ruairiD11/ProjectY4/circuitDiagrams/controllingDCMotorPushButton.jpg

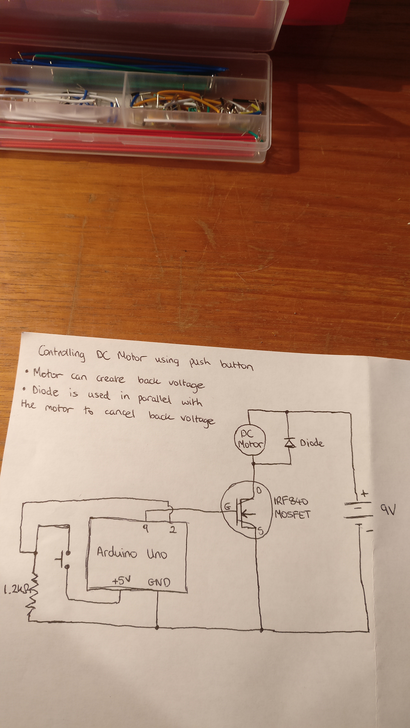
circuitDiagrams/controllingDCMotorPushButton.jpg
