ruairiD11/ProjectY4/circuitDiagrams/controlingDirectionDCMotorL293D.jpg

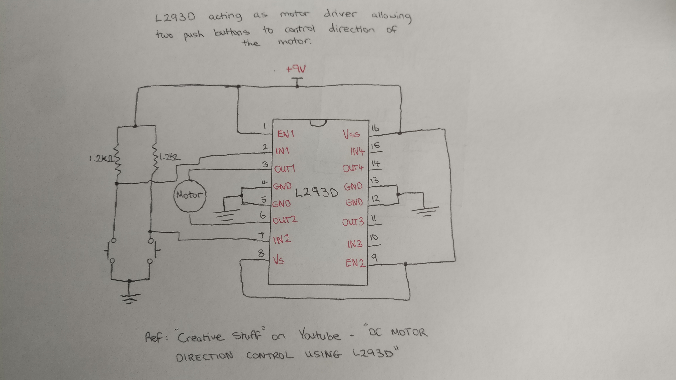
circuitDiagrams/controlingDirectionDCMotorL293D.jpg
