ruairiD11/ProjectY4/Remote-Robot-Report.pdf

Remote-Robot | Ruairí Doherty

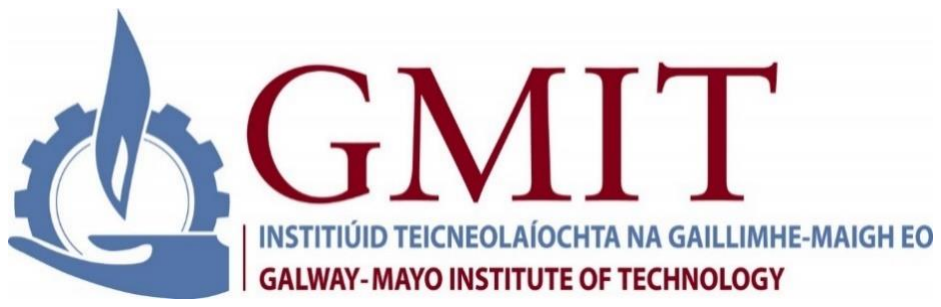
[picture p4: figure]

# Remote-Robot

# Final Year Project

# Ruairí Doherty

# Bachelor of Engineering (Hons) in Software & Electronic Engineering

# Galway-Mayo Institute of Technology

2019/2020

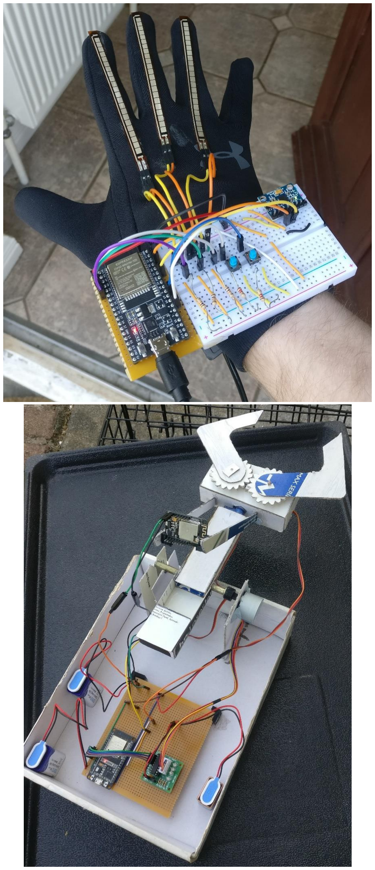
[picture p5: figure]

# Declaration

This project is presented in partial fulfilment of the requirements for the degree of Bachelor of Engineering (Hons) in Software & Electronic Engineering at Galway-Mayo Institute of Technology.

This project is my own work, except where otherwise accredited. Where the work of others has been used or incorporated during this project, this is acknowledged and referenced.

Ruairí Doherty

# Acknowledgements

Paul Lennon, Lecturer, Software & Electronic Engineering, Galway-Mayo Institute of Technology.

Niall O’ Keeffe, Lecturer, Software & Electronic Engineering, Galway-Mayo Institute of Technology.

Brian O’ Shea, Lecturer, Software & Electronic Engineering, Galway-Mayo Institute of Technology.

# Table of Contents

# 1. Project Overview

The Remote-Robot is a wireless, hand-gesture controlled robot. It’s purpose is for situations where precision is required, in environments that would be unsuitable for a human to operate in. For example – bomb disposal, radioactive environments or natural disaster relief. The project consists of two modules – the glove and robot arm. The glove uses flex sensors and an accelerometer to continuously monitor the user’s hand movements. It also has two push buttons to control the pitch of the robot arm. The robot module consists of two servo motors and one stepper motor. The servo motors are controlled by the flex sensors and accelerometer on the glove. The stepper motor handles the pitch of the robot, controlled by the push-buttons on the glove. Both of these modules communicate wirelessly, allowing remote control of the robot arm. A camera module mounted on the robot’s hand displays a livestream on a Node.js web-server, allowing the user to see what the robot can see. Real-time sensor data is also displayed on the server.

GitHub repository: https://github.com/ruairiD11/ProjectY4

# 2. Project Architecture

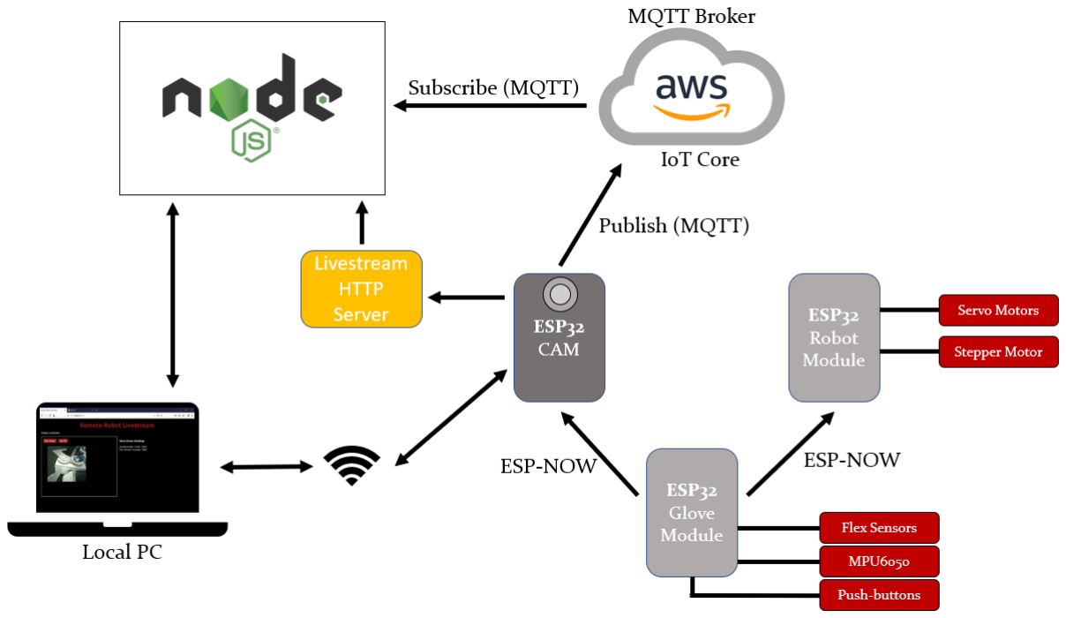
[picture p6: figure]

# 3. Schematics

## Glove Module

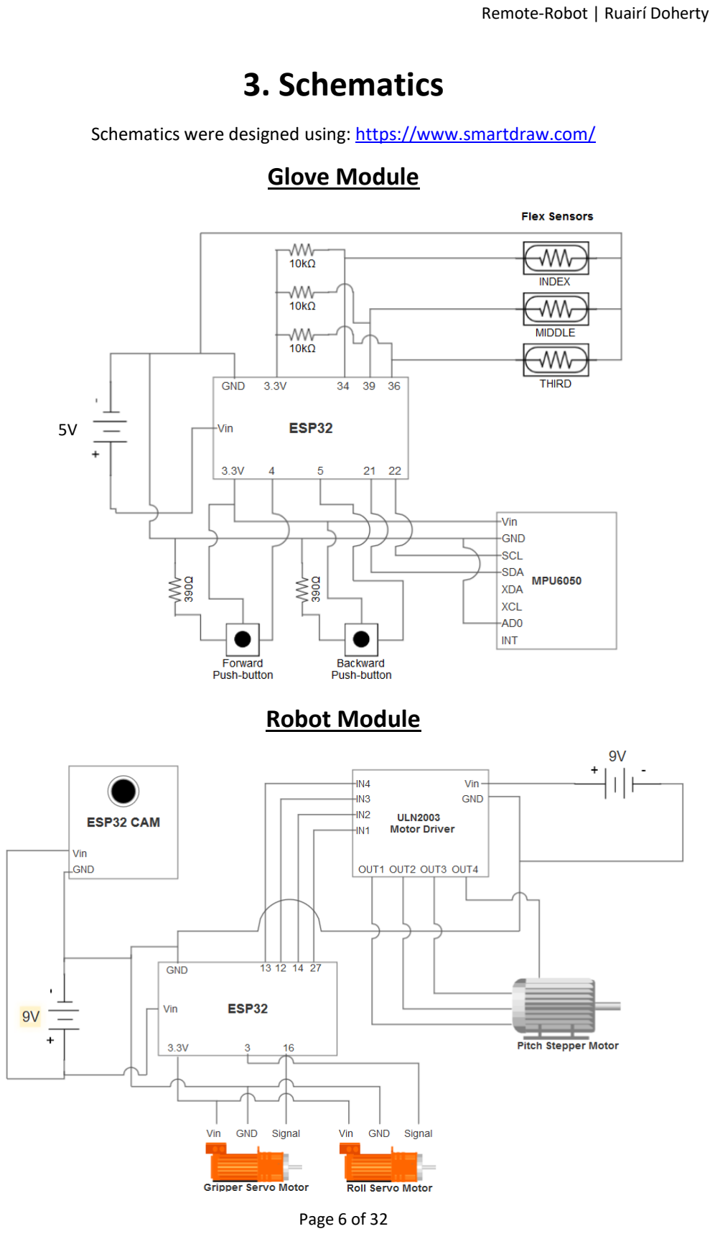
[picture p7: page 6]

Schematics were designed using: https://www.smartdraw.com/

## Robot Module

5V

# 4. Project Requirements

## 4.1 Functional

- The glove and the robot arm must communicate wirelessly.
- The glove module should be equipped with many sensors, to monitor the user’s hand movements.
- The Remote-Robot should accurately imitate the user’s hand movements.

## 4.2 Non-Functional

- The Remote-Robot should be able to be controlled from a significant distance (150 metres or more).
- The Remote-Robot should receive the glove sensor data every 50ms or less.
- The Remote-Robot should preserve as much power as possible whilst in Idle mode.

# 5. Introduction

For this project, I wanted to combine the software and hardware knowledge I’ve gained from my four years studying this course. I knew I wanted to have a glove module involved, as this would consist of many sensors. Initially, I thought of having a glove that could read sign language. It would convert sign language into speech through a speaker or text on a screen, but this idea didn’t materialise. I enjoy the process of designing and building things, so I thought of building a robot arm that could be controlled by hand movements. I felt this idea would allow me to display my knowledge of both hardware and software, whilst also allowing me to design, prototype and build a robot arm.

The first semester of working on the project was mostly experimentation with different hardware components, and trying to establish what would end up in the final product. During this time, I was testing using the Arduino Uno development board, along with a 32-bit Arduino-compatible microcontroller called the Teensy LC. I was programming in the Arduino IDE, but was continuously looking to veer away from this environment. By the end of first semester, I had a prototype built of the robot arm and had it controlled by hand movements. I needed to have the two modules communicate wirelessly. I had experimented with different stand-alone Wi-fi modules such as the ESP8266 ESP-01 with no success. At my demonstration at the end of first semester, I was advised to switch over to using the ESP32 development board as it has built-in Wi-fi capabilities. So over the Christmas break I looked to do just that. This decision had many pros, with the only con being that I would now need to migrate all the work done from first semester on the Arduino Uno, over to the ESP32.

# 6. Work Breakdown Structure

Figure 6.1, on the next page, shows the breakdown of work for my second semester (January – April). As I needed to essentially restart the project with a new development board, I planned out one/two week sprints to make sure I got back on track as soon as possible. This is how I planned it out:

20th January – 3

rd February (2 week sprint): For migrating all work accomplished from first semester into Eclipse, to have the same functionality with the ESP32.

3

rd February – 17th February (2 week sprint): Research and implementation of wireless communication between the glove and robot arm.

17th February – 3

rd March (2 week sprint): For optimizing the overall performance on my prototype – this included introducing task synchronisation/ communication using FreeRTOS communication objects and mechanisms such as queues, task notifications and event groups.

3

rd March – 17th March (2 week sprint): Planned to set-up the Node.js server that displays sensor data and a livestream.

9

th March – 16th March (1 week sprint): For adding any additional hardware features – stepper motors, OLED screen.

17th March – 31st March (2 week sprint): For designing and assembling the final robot arm.

7

th April – 27th April: The final twenty days was for work on project deliverables and any final adjustments before the demonstration.

This plan helped me meet my deadlines on a regular basis, and in turn, get my project back on schedule.

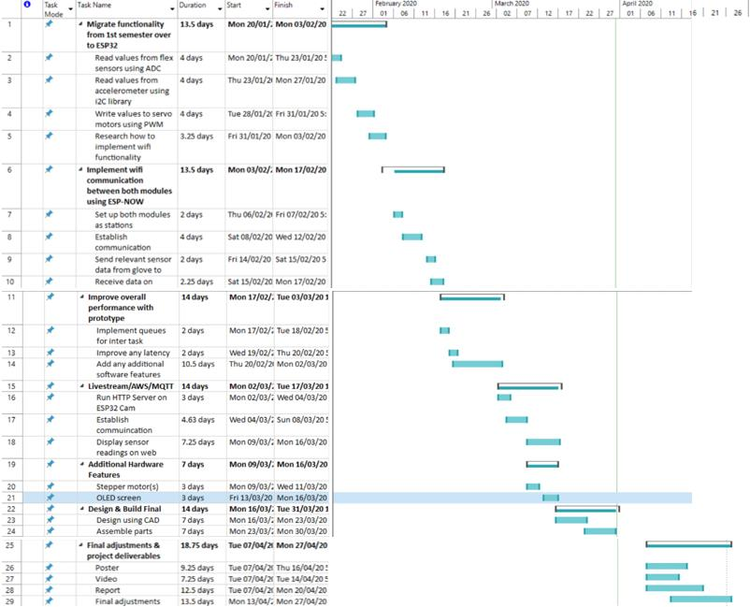
[picture p8: figure]

Figure 6.1 – Remote-Robot Second Semester Work Breakdown Structure

# 7. ESP32 Overview

There are many variations of ESP32 development boards. I am using the ESP32 DevKit V1 provided by DOIT, which evaluates the ESP-WROOM-32 module. It uses the Tensilica 32-bit Single/Dual-Core CPU Xtensa LX6 microcontroller. The ESP32 boasts many features such as built-in Wi-fi, Bluetooth, Ethernet and Low-Power capabilities. Along with this, it has 36 GPIO pins, which includes 12 ADC pins, 2 DAC pins, and the capability to interface with protocols such as I2C, SPI and UART. With a clock speed of up to 240 MHz, this board is extremely powerful, very adaptable and cheap. I picked them up for less than €10 each. See Figure 7.1 for the pin-out diagram.

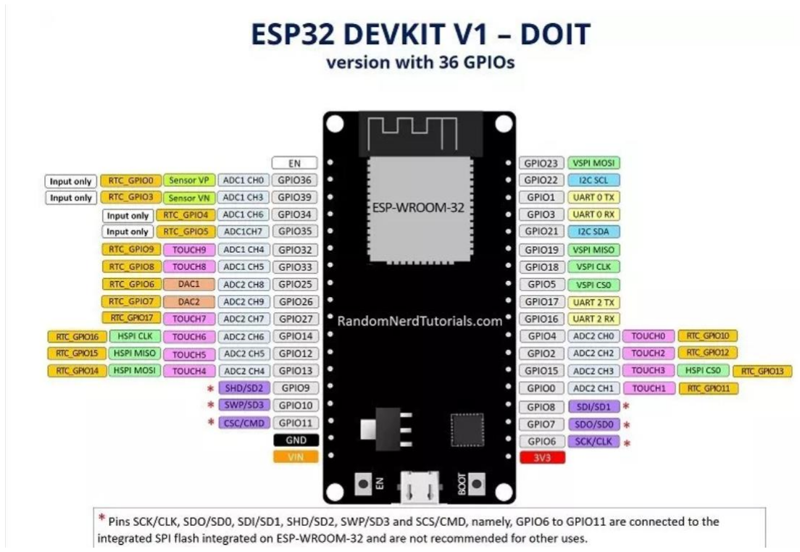
[picture p9: figure]

Figure 7.1 – ESP32 DevKit V1 DOIT Pin-out Diagram, Source – [1]

# 8. Development Platform & Tools

As mentioned before, I wanted to veer away from programming my ESP32 boards within the Arduino IDE. This is because if I was to work within the Eclipse IDE, I could program in plain C, and this would result in better overall computational efficiency. Most of the libraries provided to you by Arduino are designed for quick development of code, and generally don’t take performance into consideration. This is why I opted to use the Eclipse IDE, as it allows me to communicate with the hardware at a lower level and increase efficiency.

In order to program within Eclipse I needed to download Espressif’s Integrated Development Framework (ESP-IDF) and install toolchains that allow me to compile, debug and flash my ESP32 from the Eclipse environment. These tools included CMake, Ninja build tool, cross-compilers and OpenOCD for debugging. The ESP-IDF itself consists of the API with all the libraries and source code required to interface with the ESP32. Espressif provides a thorough tutorial on the setup of their integrated development framework [2].

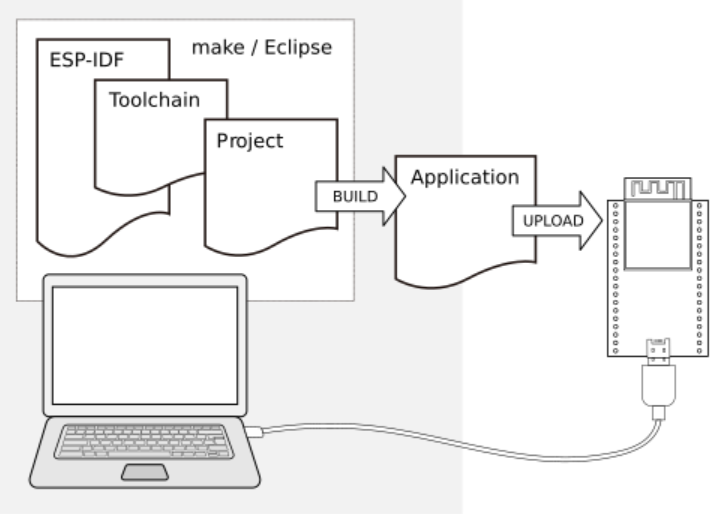
[picture p10: figure]

Figure 8.1 – “Development of applications for ESP32”, Source – [2]

# 9. Glove Module

## 9.1 Flex Sensors

A flex sensor essentially acts as a variable resistor. The more the it is bent, the more internal resistance it has, thus reducing the amount of voltage output. We can monitor the voltage output of these sensors to determine how much they are being bent. It has two nonpolarized terminals – one connected to a positive power source, and one connected to ground. These sensors are ideal for the glove module of my project. I have three of these sensors attached to the index, middle and third finger of my glove. Each are connected to a 10kΩ pull-up resistor and ground. I am using three separate ADC channels from the ESP32 to read the raw voltage values of the flex sensors. I calculate the average value of the three sensors, use the map function, and send this value as a task notification to the accelerometer task. I haven’t got the strongest connection between the flex sensors and the ESP32, so I can get some inconsistent readings. I tested each sensor to see what output each was giving me. I noticed some irregularities with each particular sensor, and came up with a software solution for each. For example, the index finger’s sensor would stay at 4095 (highest reading) when the finger was in the resting position. So I’ve used an if statement to check if it reads 4095, and if so, set the value to its lowest value which would be 2500. This isn’t a problem if I physically apply pressure to the connections to the sensors – I receive a much cleaner output. I improved this again by storing the last value of each flex sensors, along with their current reading and getting a smoother average. I talk more about this in section 15 - Performance Improvements.

## 9.2 MPU6050

A major functional requirement of my project is to monitor the user’s precise hand movements, so I needed to find a device that would allow me to do so. The MPU6050 is an Inertia Measurement Unit (IMU) with a built-in accelerometer and gyroscope. IMUs are common in real-world applications such as self-balancing robots, quadcopters and smartphones [3]. Not only does the MPU6050 produce accurate readings, but it is also very inexpensive. From my experience using it, I can safely say it was the correct choice. The MPU6050 uses the I2C protocol for communication. I made use of the accelerometer in particular for this project, in order to monitor the orientation of the user’s hand in the y-axis. From my understanding, the accelerometer produces a change in output proportional to a change in the gravitational force on a particular axis (x,y or z). In order to interface with this component, I required the services of the I2C library provided in the ESP-IDF. I configured the device with the aid of Neil Kolban’s technical tutorial on the MPU6050 [4]. In order to retrieve the data from the MPU6050, I need to read from the six accelerometer registers, as shown in Figure 9.2.1.

Figure 9.2.1 – MPU6050 Accelerometer Registers, Source - [5]

There is a high and low register for each of the x, y and z values. Beginning at ACCEL_XOUT[15:8], I loop through the registers down until ACCEL_ZOUT[7:0]. Once reading each register I’m left with six values. I then must use bit masking and shifting in order to combine the high and low values of each, and obtain the final x, y and z readings (the difference between the high and low values). I only require the y value, to control the roll servo of the robot arm.

# 10. Robot Module

## 10.1 Servo Motors

Inside a servo motor, you will find a small DC motor, a potentiometer and a control circuit. How it works is, as the DC motor rotates, so does the potentiometer, so the control circuit is able to decipher how much movement is occurring and in which direction. The servo has three inputs – Vin, GND and Signal. The signal input receives electrical pulses which determines the desired position of the motor. I have two SG90 servo motors on my robot module – the gripper and the roll servo. SG90 servo motors are small and cheap, so I bought them in bulk. The gripper servo’s desired position is determined by the average value of the three flex sensors. The roll servo is determined by the y-axis value from the accelerometer. In order to interface with the servo motors I use Pulse Width Modulation (PWM). PWM is used to encode data in a signal, by using the duration that the signal is high, relative to the duration that the signal is low. The duty cycle is what determines the ratio of how long the signal is high versus low within that signal’s frequency, and is measured in bits. So the duty cycle of the gripper servo is the average value of the flex sensors, and the duty cycle of the roll servo is the y value of my accelerometer. The ESP-IDF provides a library for implementing PWM called ledc, which stands for Light Emitting Diode Controller. It is the same principle applied if you are controlling the brightness of an LED, or in my case, positioning a servo motor. Once again, I used Neil Kolban’s resources to aid me in the configuration of PWM [6].

## 10.2 Stepper Motor

To add another degree of freedom (DoF) to the robot arm, I wanted to be able to control it’s pitch. I could have added an additional servo motor to do this, but I came to the conclusion that this would not be a feasible option. Instead, I came up with a more appropriate solution:

The pitch does not need to be continuously monitored and updated, as this would unnecessarily require more of the CPU’s resources. The glove module already has to continuously poll the readings from the accelerometer and flex sensors. I thought that having two push-buttons attached as interrupts would be a much more efficient way of controlling the pitch. The glove module has two push-buttons that are connected to the ESP32 as external interrupts – one to pitch forward and one to pitch backward. Whenever they are pressed, an interrupt occurs and changes the state of their respective variable from 0 to 1. These variables are sent as part of the ESP-NOW packet to the robot module. On the robot’s side, it is continuously receiving these data packets including the state of the push-buttons. If it receives a value of 1 for one of these buttons, it recognizes that the button was pressed, and can perform the appropriate algorithm, as I will outline next.

Stepper motors consist of multiple coils that are grouped into phases or steps. If these phases are electrically powered in sequence, the motor will output a single step. I am using the 28BYJ-48 stepper motor along with the ULN2003 motor driver. The motor has 4 inputs (IN1, IN2, IN3, IN4) that connect to the motor driver. The driver is powered by its own independent 9V battery. With the knowledge that the motor will produce a single step if it’s four inputs are powered in sequence, I came up with an algorithm to automate this process:

Firstly, I needed to create the sequence that the stepper should undertake when it is required to pitch forward or backward. I thought that creating an array for each the forward and backward sequence was a good way to do it. Imagine that each of these two arrays are broken into four sub-arrays:

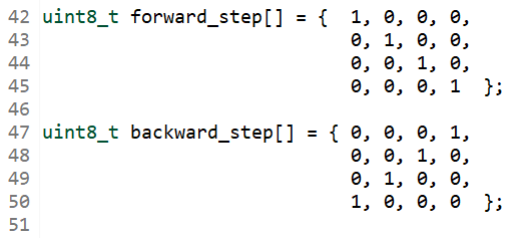
[picture p11: figure]

Figure 10.2.1 – Forward & Backward Stepper Sequence

For example, if the stepper motor is told to pitch forward. It needs to loop through the forward_step array, assigning each of the stepper’s four inputs (IN1 – IN4) to it’s respective index in each sub-array.

IN1 IN2 IN3 IN4

Figure 10.2.2 – Sub-Arrays

After one iteration through the forward_step array, the stepper performs a single step. However, I noticed that a single step is extremely miniscule and hard to see. So I needed to create a nested for loop, that would perform an iteration through the array multiple times. I figured that twelve iterations produced a sufficient output:

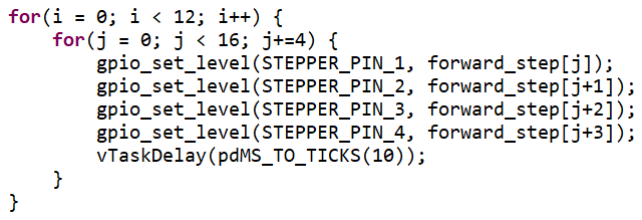
[picture p12: figure]

Figure 10.2.3 – Nested For Loop

As can be seen in Figure 10.2.3, the inner for loop iterates through each sub-array, assigning each stepper input pin to its respective value. This for loop (without the outer loop) executes four times. The index variable, j, increments by four each time so that it begins at the first index of each sub-array, for each iteration. The outer loop then executes this whole sequence twelve times, with a very short delay of 10ms in between. This results in a significant pitch forward, performed very quickly.

1st Sub-Array

2

nd Sub-Array

3

rd Sub-Array

4

th Sub-Array

## 10.3 ESP32 Camera

The ESP32 camera module has a lot of the same functionality as a regular ESP32 development board (built-in Wi-fi and Bluetooth, GPIO pins), with the added feature of the OV2640 camera. There is an example sketch in the ESP32 Arduino library that starts a HTTP web-server and displays a livestream. I can’t take credit for creating this server and interfacing with the camera (I have referenced to it in the code), but I have stripped down the HTML so that I only have the elements I require for my project. As a quick reference, see Figure 10.3.1 for what the original web-page looks like.

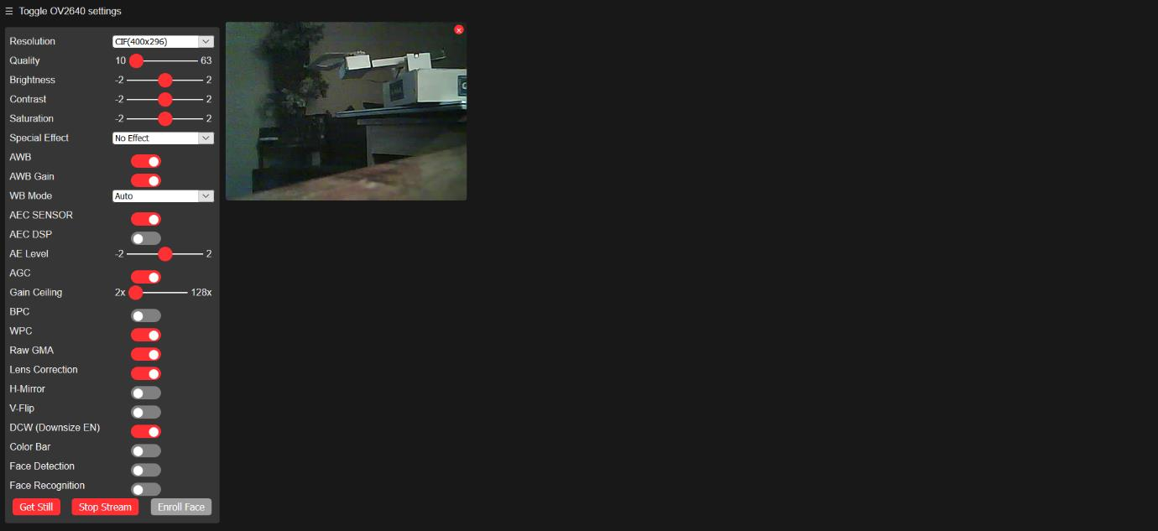
[picture p13: figure]

Figure 10.3.1 – ESP32 Camera Web Server Original Web-Page

The original web page has many options for changing the configurations of the display, and also some face recognition capabilities. I didn’t need all this functionality, so I edited the HTML code to just have a button to display the livestream. However, the HTML file is given as an array of hexadecimal values in a header file (See Figure 10.3.2). I needed to convert it back to a HTML format in order to edit it. For this, I used this web application called CyberChef used for code decoding and compression ( https://gchq.github.io/CyberChef ). Once I was happy with the HTML code, I needed to convert it back into an array of hex values, and place it into the camera_index.h file.

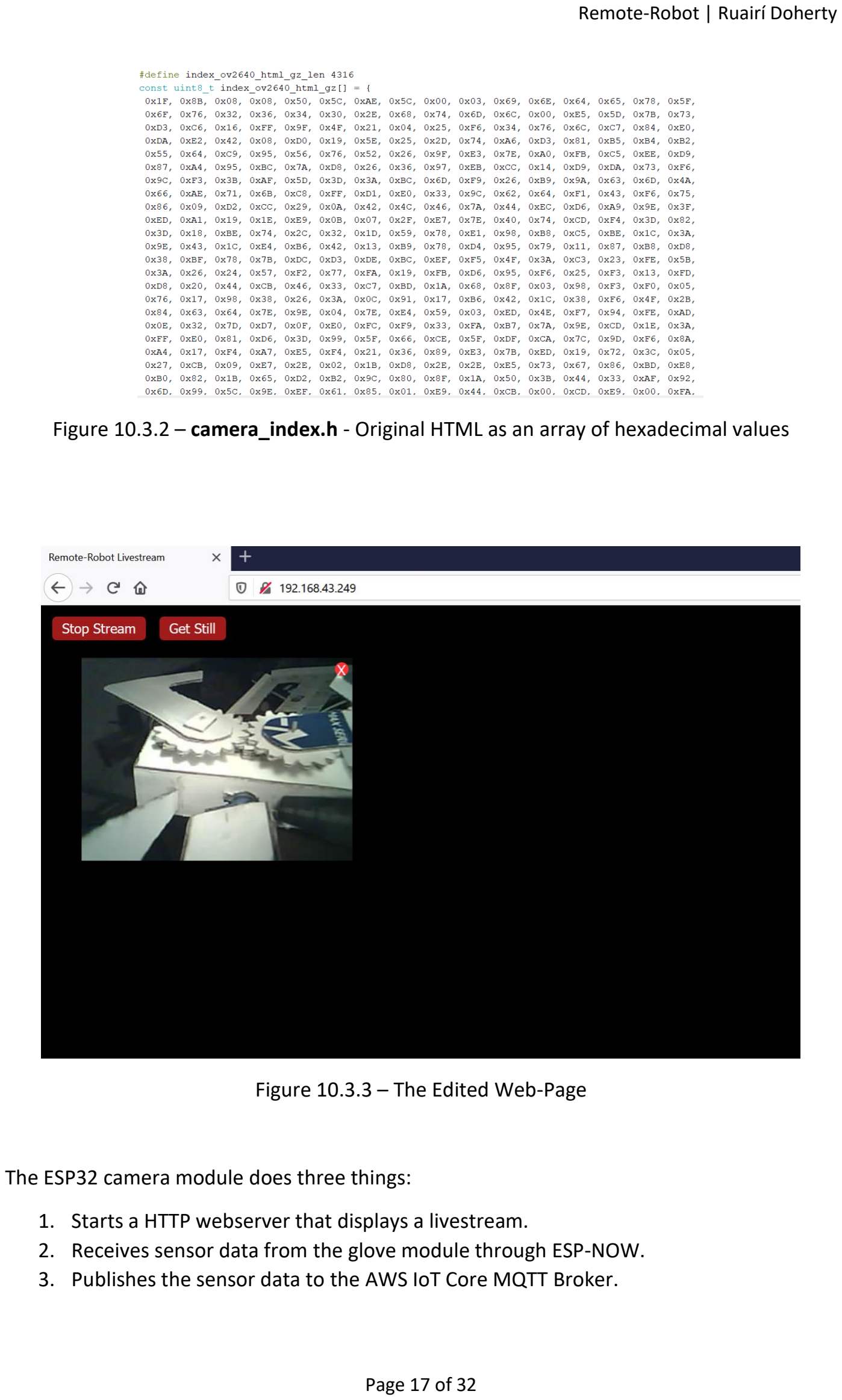
[picture p14: page 17]

Figure 10.3.2 – camera_index.h - Original HTML as an array of hexadecimal values

Figure 10.3.3 – The Edited Web-Page

The ESP32 camera module does three things:

1. Starts a HTTP webserver that displays a livestream.
2. Receives sensor data from the glove module through ESP-NOW.
3. Publishes the sensor data to the AWS IoT Core MQTT Broker.

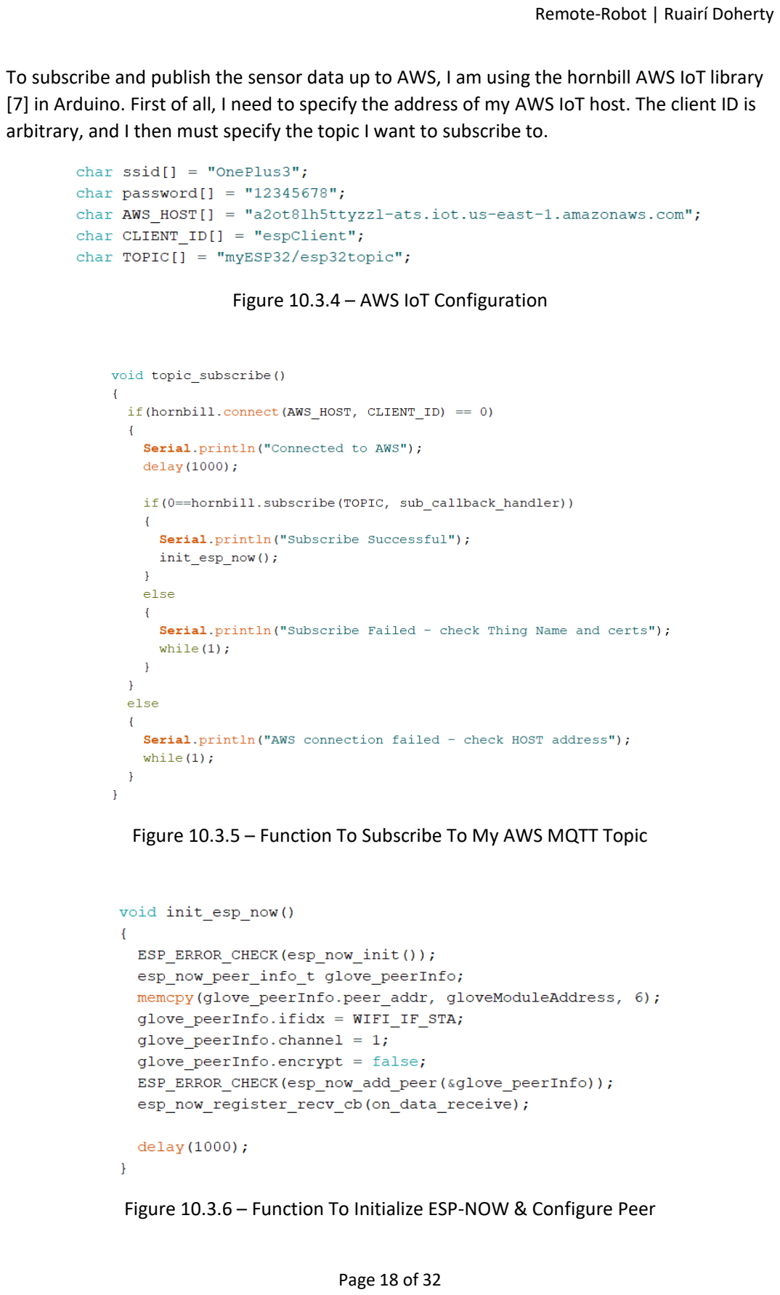
[picture p15: page 18]

To subscribe and publish the sensor data up to AWS, I am using the hornbill AWS IoT library
[7] in Arduino. First of all, I need to specify the address of my AWS IoT host. The client ID is arbitrary, and I then must specify the topic I want to subscribe to.

Figure 10.3.4 – AWS IoT Configuration

Figure 10.3.5 – Function To Subscribe To My AWS MQTT Topic

Figure 10.3.6 – Function To Initialize ESP-NOW & Configure Peer

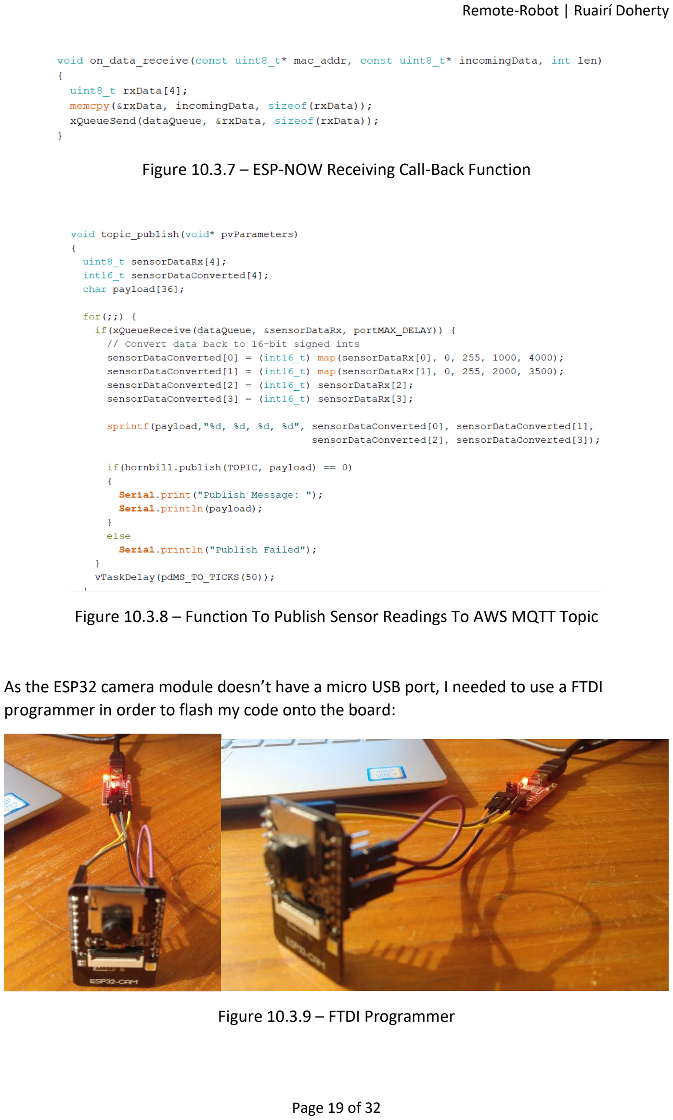
[picture p16: page 19]

Figure 10.3.7 – ESP-NOW Receiving Call-Back Function

Figure 10.3.8 – Function To Publish Sensor Readings To AWS MQTT Topic

As the ESP32 camera module doesn’t have a micro USB port, I needed to use a FTDI programmer in order to flash my code onto the board:

Figure 10.3.9 – FTDI Programmer

# 11. AWS IoT Core

I am using Amazon Web Service’s Internet of Things Core in order to route the sensor readings to my Node.js server. The ESP32 Camera module publishes the array of data as a string to AWS using the MQTT protocol. MQTT is a lightweight messaging protocol that uses the idea of publishing and subscribing to a particular broker. In my case, the broker is set up on the AWS IoT Core. The ESP32 camera module publishes the data. My Node.js server then subscribes to that particular topic on the broker, in order to retrieve the sensor data. From the AWS IoT console, I can subscribe to my topic (myESP32/esp32topic), and see the packet of data being received.

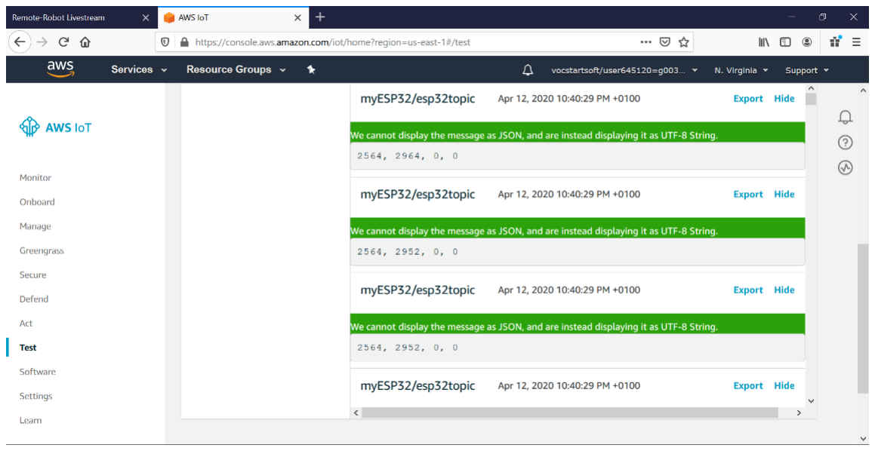
[picture p17: figure]

Figure 11.1 – AWS IoT Core MQTT Client

# 12. Node.js Express Server

A Node.js server runs locally on my computer. It displays a web-page with a livestream from the robot arm, plus some real-time sensor data. The livestream is displaying on a separate HTTP server running on the ESP32 camera module. Using a HTML iFrame, I can essentially embed the livestream web-page within my main web-page. If “Display Livestream” is clicked, it redirects to the livestream server (192.168.43.249), and displays it within the iFrame.

The node.js server subscribes to my MQTT topic on the AWS IoT Core, in order to pull the sensor data. The data is received as a string, so I need to parse each value from the string. Using AJAX (Asynchronous JavaScript And Xml), I can dynamically update the sensor readings, without the need to refresh the page. It uses a XMLHttpRequest to request the data. Inside my JavaScript code, I have it continuously sending these requests and updating the respective HTML element, with the new sensor value.

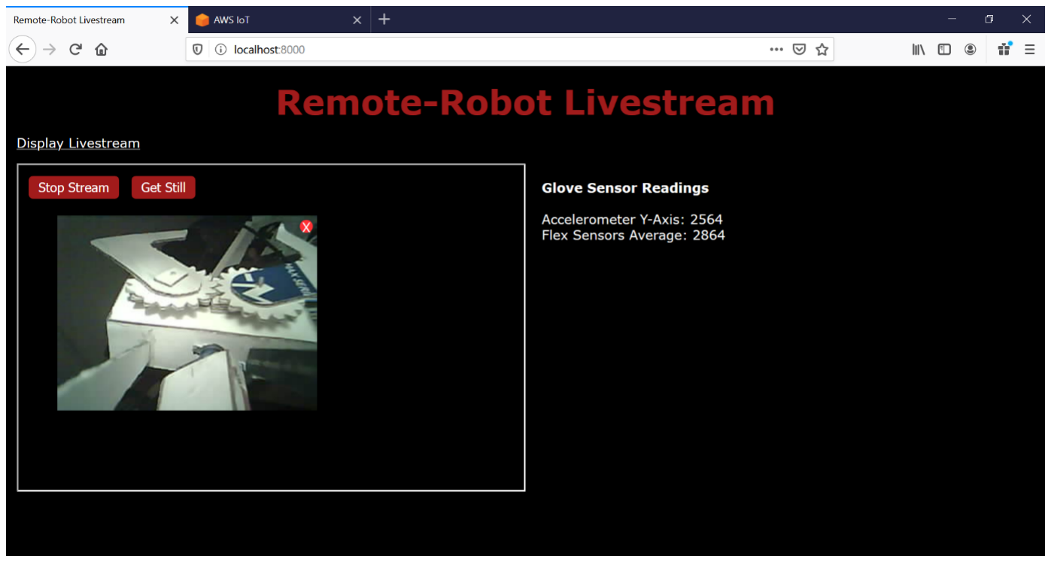
[picture p18: figure]

Figure 12.1 – Node.js Web-Page

# 13. Wireless Communication

## 13.1 ESP-NOW

In order to meet the requirement of allowing the robot arm to be controlled remotely, I needed to find a means of wireless communication between the glove and robot module. I discovered that Espressif had developed their own wireless protocol called ESP-NOW. ESP-NOW is a peer-to-peer wireless protocol, without the need for Wi-fi. It allows up to 250 Bytes of data to be sent at a time. It would be similar to the 2.4GHz wireless communication you would get with a wireless mouse or TV remote [8]. It is a very simple and lightweight means of communication between ESP devices. All that is required is knowledge of the MAC address of the device you want to talk to. Once a device is configured as a peer, you are free to send and receive data. The default bit rate of ESP-NOW is 1Mbps. It is a reliable and fast protocol, without the trouble of connecting to access points.

If the device is the transmitter, it must specify a sending call-back function that executes every time data is sent. The receiving device must specify a receiver call-back function every time data is retrieved.

The packet of data being sent from the glove to the robot is an array consisting of four unsigned 8 bit integers. These four values are the Y-axis value of the accelerometer, the average of the three flex sensors, the state of the forward pitch button, and the state of the backward pitch button. I need to convert the accelerometer and flex sensor average to unsigned 8 bit integers before transmitting, as it is a requirement when using ESP-NOW.

Figure 13.1.1 – My ESP-NOW Data Packet

Accel_Y | Flex_Avg | Forward_Pitch | Backward_Pitch

## 13.2 Range

I tested the range of communication between the glove and robot arm, and found that the robot can be controlled from at least 215 metres away. It could actually be remotely controlled at a further distance, once there is a minimal amount of obstacles in between both modules.

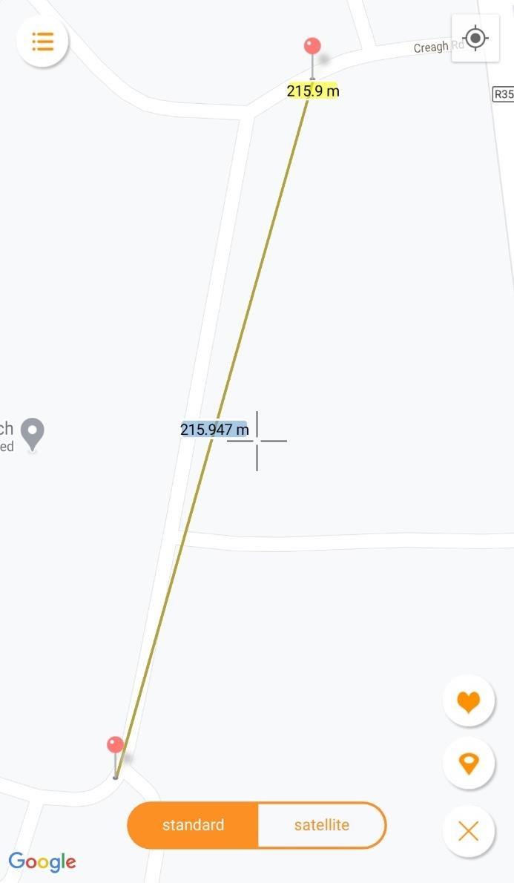
[picture p19: figure]

Figure 13.2.1 – Range Of Communication Between Glove and Robot Arm

# 14. FreeRTOS Task Synchronization

The ESP-IDF implements a version of Amazon’s FreeRTOS, which I would have some experience using in first semester. With FreeRTOS, you can achieve real-time task synchronization using communication objects such as queues, task notifications, event groups and semaphores. I have my programs configured for pre-emptive scheduling. Pre-emptive scheduling is where the execution of the program is decided by the priority of tasks. If a higher priority task is ready to run, it will pre-empt any lower priority tasks. This allows faster response times for tasks that are of higher importance.

## 14.1 Glove Module Task Timing Diagram

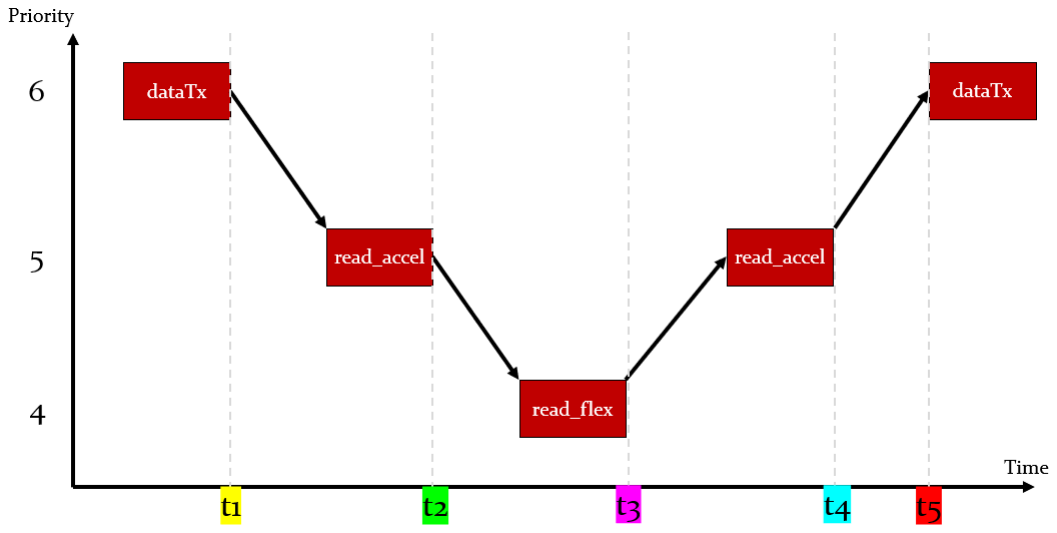
[picture p20: figure]

t1 – dataTx begins executing but is blocked waiting for an incoming queue containing the sensor data from the accelerometer task.

t2 – read_accel is the next highest priority task, so it begins execution. It reads the y-axis value from the accelerometer and then blocks waiting for a task notification from the flex sensor task.

t3 – read_flex retrieves the average value of the three flex sensors and sends this value as a task notification back to the accelerometer task.

t4 – read_accel is now unblocked as it has received the notification from read_flex. The sensor data is then mapped down to the range 0-255 using the map() function, and then sent in a queue up to dataTx.

t5 – dataTx is then unblocked after receiving the packet of sensor data. It can then send the data as an array of unsigned 8-bit integers to the robot and camera modules using ESP-NOW.

## 14.2 Robot Module Task Timing Diagram

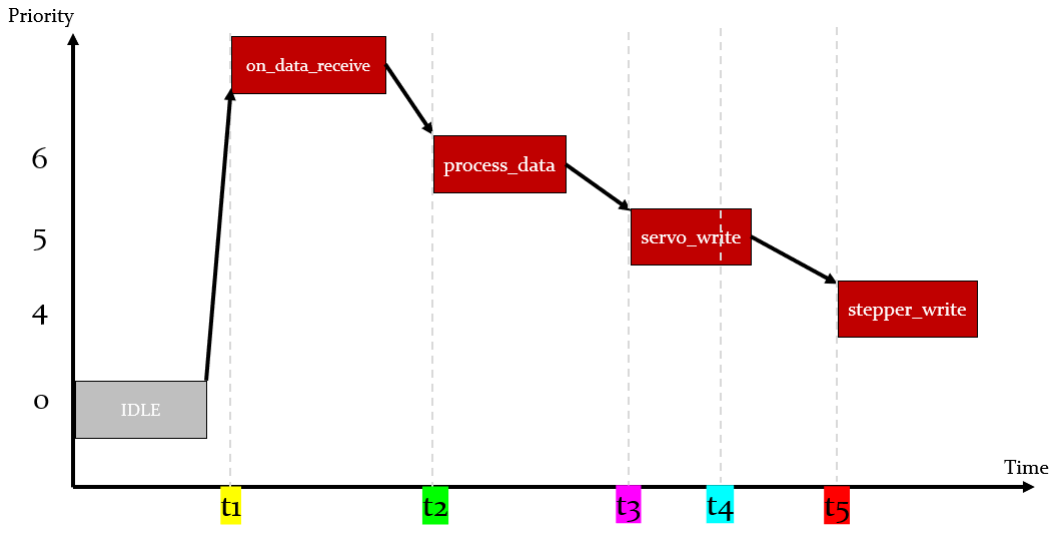
[picture p21: figure]

t1 – IDLE task is running as all tasks are in a blocked state. At t1, the glove module is powered on and begins transmitting data to the robot module. on_data_receive is a call-back function that runs when data is received through ESP-NOW. It defers the processing of the data to another task by sending the it in a queue. This is to make sure the execution time of the call-back function is kept as short as possible.

t2 – process_data unblocks after receiving the queue. It converts the data back into 16-bit signed integers and sends a queue to the servo task.

t3 – servo_write uses Pulse Width Modulation to update the duty cycle of the signal being sent to both of the servo motors. It also checks if the state of the forward/backward pushbutton has changed to 1.

t4 – The forward pitch button is pressed on the glove module. This causes an interrupt on the glove’s side, and sends the state of the button to the robot. In servo_write, it notices that the forward_state variable has changed from 0 to 1. This causes a flag in an event group to be set.

t5 – stepper_write unblocks when it recognises that the pitch forward flag in the event group has been set. This then performs the operation to pitch the robot arm forward.

## 14.3 Other Functions

I will breakdown the other functions/handlers (not FreeRTOS tasks) that appear in my code.

wifi_init() – This function is common to both the robot and glove module, and is the first function that executes. It initializes Wi-Fi and ESP-NOW. It then configures the other devices as peers, to allow for ESP-NOW communication.

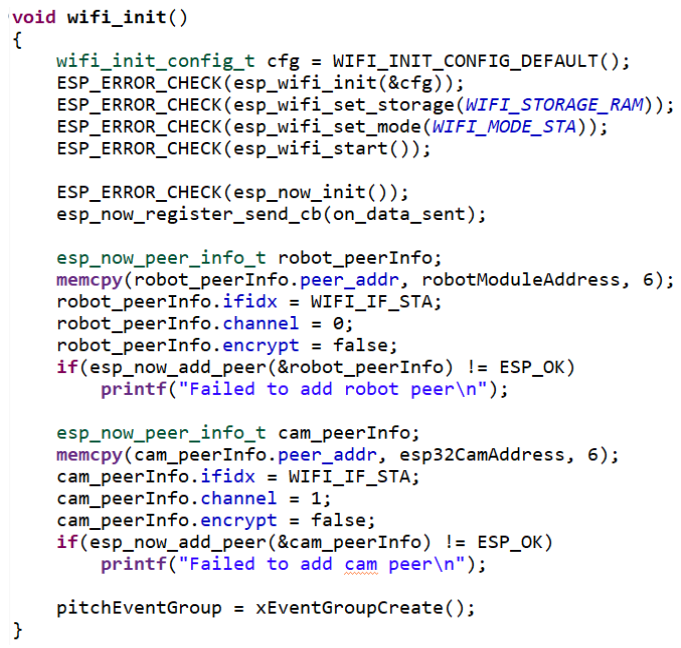
[picture p22: figure]
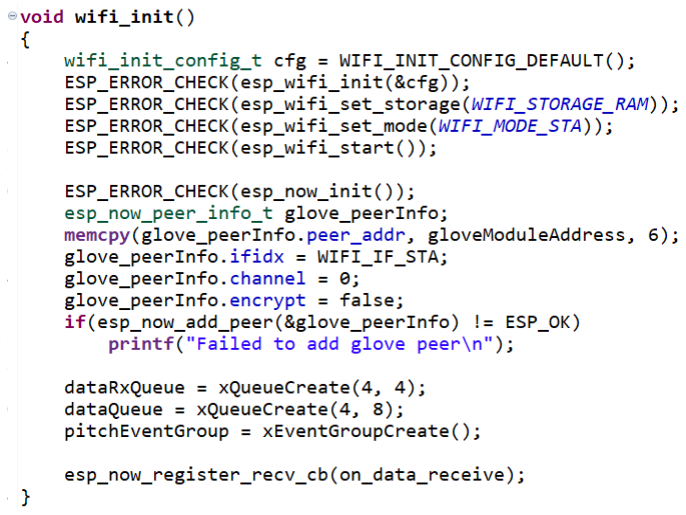
[picture p23: figure]

gpio_interrupt_config() – (Exclusive to Robot Module). Configures the two push-buttons as external interrupts (GPIO4: Forward, GPIO5: Backward). They are set-up to occur on a risingedge as these buttons are active-high. It also configures the interrupt service routine handler for each button.

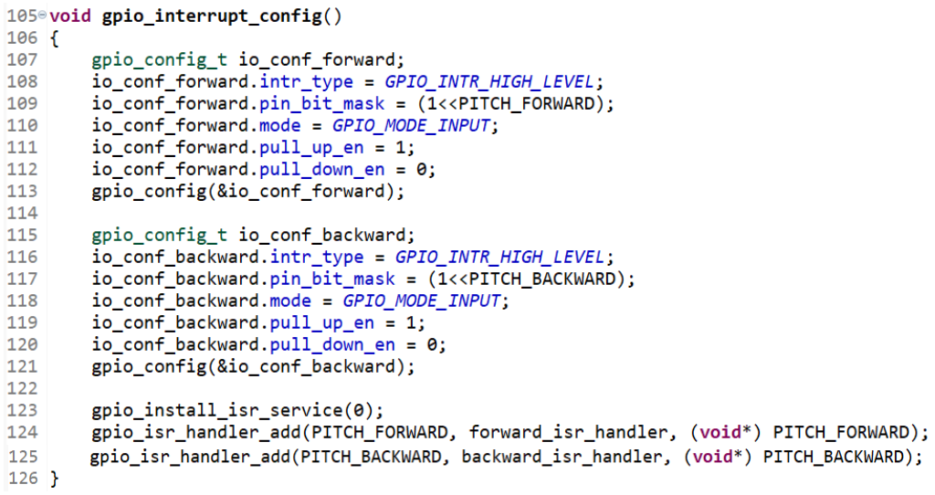
[picture p24: figure]

map() – (Also used on both modules). This algorithm, provided by Arduino [9], allows me to map a variable to a more desirable range. This helps for mapping my 16-bit signed integer values (y-axis accelerometer and flex sensor average) down to the range of an unsigned 8-bit integer (0-255). I need to do this before transmitting the data using ESP-NOW. The first parameter it takes is the variable you want to map. The second and third are the minimum and maximum range of that variable. The last two parameters are the minimum and maximum range that you want to map to.

The glove module has two interrupt handlers:

forward_isr_handler() –Interrupt handler for the pitch forward button (GPIO4). When an interrupt occurs, it changes the global variable, forward_state, to 1.

backward_isr_handler() - Interrupt handler for the pitch backward button (GPIO5). When an interrupt occurs, it changes the global variable, backward_state, to 1.

on_data_receive() – (Robot module). ESP-NOW call-back function that executes whenever data is received. It uses a queue to send the received data to another task for processing. This is to keep the call-back function as short as possible, as it interrupts the rest of the code.

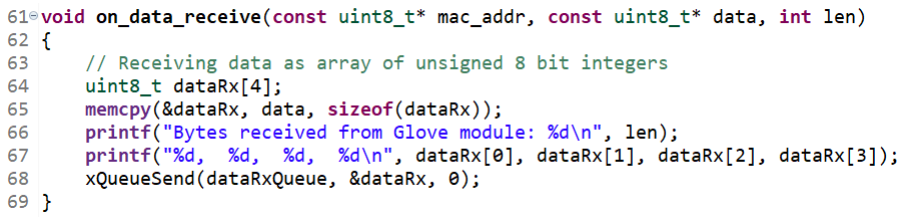
[picture p25: figure]

on_data_sent() – (Glove Module). ESP-NOW call-back function that executes whenever data is sent. It displays whether or not the data was transmitted successfully.

# 15. Performance Improvements

## 15.1 Flex Sensor Smoothing Average

A problem I’ve had throughout this whole project, was that I was getting an inconsistent output from my flex sensors. This was to be expected as I am reading the average value of three sensors, rather than one, meaning it can be more prone to a sporadic output. Another reason why this was happening is because the hardware connections attached to the sensors are not the best, so they can momentarily disconnect causing spikes/drops in the output. I couldn’t really do much about the hardware connections as they were glued to the glove, and I didn’t want to have to get a new glove with new flex sensors and connections. So I had to come up with a software solution to the problem. The first thing I did was isolate each sensor and test it to see if it was producing sporadic readings. I noticed each sensor had its own unique defect – for example, the sensor on the index finger sensor produced a value of 4095 (maximum value) when the finger is in the resting position (it should be at its minimum value). So I needed to add an if statement to check if it is at 4095, then change it back to 2500 (minimum value). This helped, but there was still room for improvement.

I researched the idea of a Moving Average Filter (MAF) which essentially regulates a set of data. This gave me the idea to store the last reading of each sensor, along with its current reading. This meant I now had six values (last reading and current reading for the three flex sensors). I would then calculate the average of these six values, resulting in a much smoother output on the gripper servo motor.

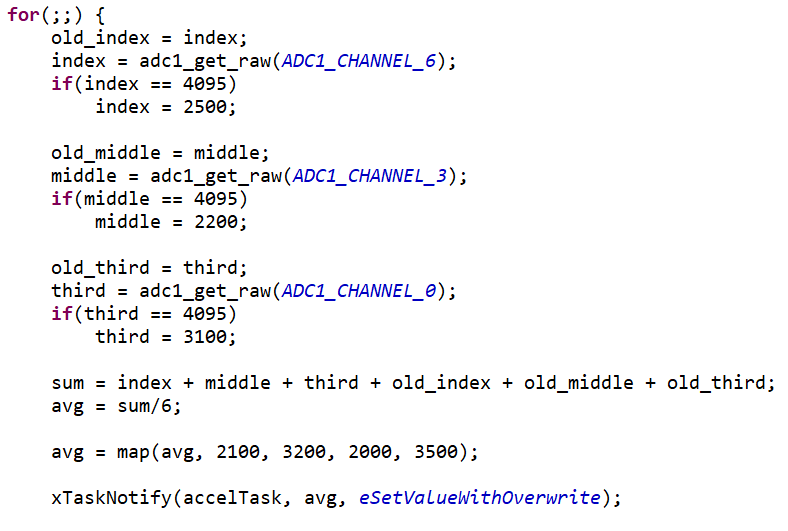
[picture p26: figure]

Figure 15.1.1 – Flex Sensor Smoothing Average

## 15.2 Dual Core Utilization

As the ESP32 boasts two cores (APP CPU and PRO CPU), I felt it would be a good idea to take advantage of this. With FreeRTOS, you can pin certain tasks to a particular core. The last parameter in xTaskCreatePinnedToCore is for specifying the core you wish to pin that task to (Core 0 – PRO CPU, Core 1 – APP CPU):

Figure 15.2.1 – Glove Module Tasks

Figure 15.2.1 – Robot Module Tasks

This allows tasks to execute concurrently, and as a result optimize the overall performance.

# 16. 3-D Printed Parts

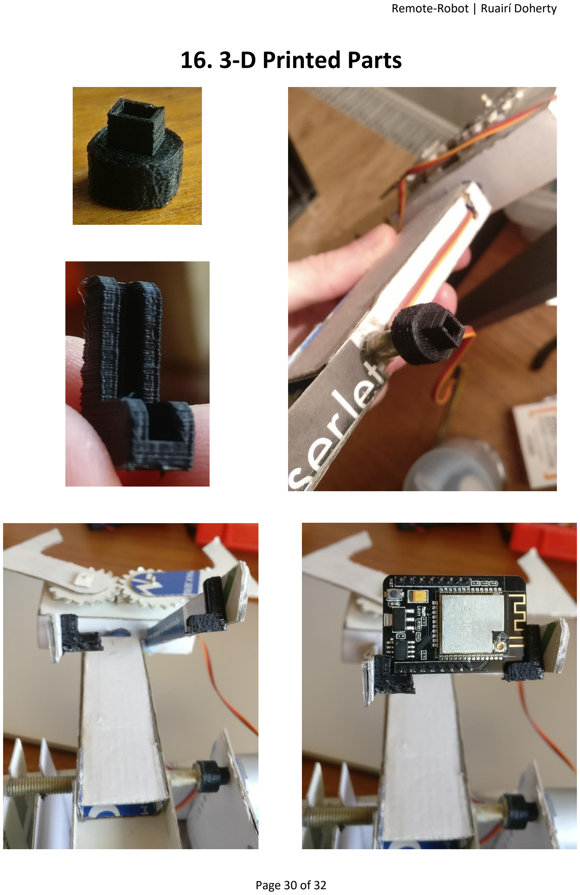
[picture p27: page 30]

# 17. Conclusion

Overall, I am happy with the result of my project. It allowed me to further my knowledge of embedded programming (especially working with FreeRTOS), which is the area I would like to get into after college. Working with AWS was also a big bonus. I also got to improve my skills with testing and designing circuits.

I had hoped to eventually have a fully 3-D printed robot arm. I received a faulty cable with my 3-D printer which meant that I essentially had no extruder motor. So, if I wanted to print something, it had to be a very small piece because I need to manually feed the filament into the printer. Due to COVID-19, this cable never arrived. However, I felt the prototype I had built from first semester was good enough to demonstrate the concept of the Remote-Robot. If I was to do this project again, I would have made the robot arm mobile, and have it fitted with a GPS tracker.

A big thing this project thought me was organization. I followed what you would see in an Agile environment, by setting one or two week deadlines to complete certain features. This allowed me extra time at the end of the project for any additional features, and for project deliverables.

# 18. References

[1] – R. Santos. (December, 2016). "Getting started with the ESP32 Development Board". Random Nerd Tutorials. [Online]. Available: https://randomnerdtutorials.com/gettingstarted-with-esp32 (https://randomnerdtutorials.com/getting-started-with-esp32)
[2] - Espressif Systems (Shanghai) CO. LTD. “ESP-IDF Programming Guide”. docs.espressif.com. [Online]. Available: https://docs.espressif.com/projects/esp-idf/en/latest/esp32/get-started (https://docs.espressif.com/projects/esp-idf/en/latest/esp32/get-started)
[3] – A. Sanjeev. (2018). “How to Interface Arduino and the MPU 6050 Sensor”. Maker Pro. [Online]. Available: https://maker.pro/arduino/tutorial/how-to-interface-arduino-and-thempu-6050-sensor (https://maker.pro/arduino/tutorial/how-to-interface-arduino-and-the-mpu-6050-sensor)
[4] – N. Kolban. (February, 2017). “ESP32 Technical Tutorials: MPU6050 Accelerometer“. YouTube. [Online]. Available: https://www.youtube.com/watch?v=HwurH20jsvw&list=PLB-czhEQLJbWMOl7Ew4QW1LpoUUE7QMOo&index=15&t=368s (https://www.youtube.com/watch?v=HwurH20jsvw&list=PLB-czhEQLJbWMOl7Ew4QW1LpoUUE7QMOo&index=15&t=368s)
[5] – InvenSense Inc. (August, 2013). “MPU-6000 and MPU-6050 Register Map and Descriptions”. Revision 4.2. invensense.tdk.com. [Online]. Available: https://invensense.tdk.com/wp-content/uploads/2015/02/MPU-6000-Register-Map1.pdf
[6] – N. Kolban. (January, 2017). “ESP32 Technical Tutorials: ESP32 and Pulse Width Modulation“. YouTube. [Online]. Available: https://www.youtube.com/watch?v=rarE-WI_Y0A&list=PLB-czhEQLJbWMOl7Ew4QW1LpoUUE7QMOo&index=24 (https://www.youtube.com/watch?v=rarE-WI_Y0A&list=PLB-czhEQLJbWMOl7Ew4QW1LpoUUE7QMOo&index=24)
[7] – S. Bagwan. (Explore Embedded). (July, 2017). “Arduino-ESP32-AWS-IoT”. GitHub. [Online]. Available: https://github.com/ExploreEmbedded/Hornbill-Examples/tree/master/arduino-esp32/AWS_IOT (https://github.com/ExploreEmbedded/Hornbill-Examples/tree/master/arduino-esp32/AWS_IOT)
[8] – Espressif Systems (Shanghai) CO. LTD. “ESP-NOW Overview”. espressif.com. [Online]. Available: https://www.espressif.com/en/products/software/esp-now/overview
[9] – Arduino. “map() function”. arduino.cc. [Online]. Available: https://www.arduino.cc/reference/en/language/functions/math/map/
