ruairiD11/ProjectY4/ESP32-CAM/camera_index.h

//File: index_ov2640.html.gz, Size: 4316
#define index_ov2640_html_gz_len 4316
const uint8_t index_ov2640_html_gz[] = {
0x1f,0x8b,0x08,0x00,0xc8,0x22,0x86,0x5e,0x00,0xff,0xcd,0x5a,0x7b,0x8f,0xdb,0xc6,0x11,0xff,0xdb,0xf9,0x14,0x3c,0xc5,0xb1,0x74,0xe8,0x49,0x3a,0xf9,0x11,0xb8,0xaa,0x74,0x46,0x6c,0x5f,0x9c,0x00,0x4e,0x5b,0xc4,0x6d,0x5a,0xa0,0x28,0xec,0x15,0x39,0x94,0xb6,0x5e,0x71,0xd9,0xe5,0xf2,0x74,0xd7,0xc3,0x7d,0xf7,0xcc,0xec,0x2e,0xc9,0xe5,0x53,0x8a,0xd1,0x02,0x95,0xfe,0x90,0xc8,0x9d,0xf9,0xed,0x3c,0x1f,0x4b,0x69,0x75,0x16,0xc9,0x50,0xdf,0xa5,0x10,0xec,0xf4,0x5e,0x5c,0x7d,0xb5,0xb2,0x1f,0x01,0xbe,0x56,0x3b,0x60,0x91,0xfd,0x6a,0x2e,0xf7,0xa0,0x59,0x10,0xee,0x98,0xca,0x40,0xaf,0x47,0xb9,0x8e,0xa7,0x2f,0x47,0xcd,0xe5,0x84,0xed,0x61,0x3d,0xba,0xe1,0x70,0x48,0xa5,0xd2,0xa3,0x20,0x94,0x89,0x86,0x04,0xc9,0x0f,0x3c,0xd2,0xbb,0x75,0x04,0x37,0x3c,0x84,0xa9,0xb9,0xb8,0xe0,0x09,0xd7,0x9c,0x89,0x69,0x16,0x32,0x01,0xeb,0x85,0x8f,0xa5,0xb9,0x16,0x70,0xf5,0x33,0xec,0xa5,0x86,0xe9,0xcf,0x72,0x23,0x75,0xf0,0x9e,0xdf,0x40,0xa6,0x15,0xb0,0xfd,0x6a,0x6e,0x97,0x2b,0xf2,0x4c,0xdf,0xf9,0xd7,0x8f,0x66,0x24,0x39,0xa8,0xe0,0xbe,0xbc,0x65,0x6e,0xc7,0x28,0xcc,0x34,0xe3,0xff,0x81,0x65,0xf0,0xec,0x32,0xbd,0xfd,0x43,0x6d,0x95,0x5e,0x1a,0x6e,0xf5,0x94,0x09,0xbe,0x4d,0x96,0x41,0x88,0x62,0x83,0xaa,0xd3,0x3c,0xd4,0xae,0x6a,0x17,0xb3,0x3d,0xe3,0xc9,0x34,0xe2,0x37,0xcd,0x4d,0x23,0x9e,0xa5,0x82,0xdd,0x2d,0x83,0x58,0x40,0xc7,0x96,0x74,0x17,0xd9,0x14,0x84,0x9a,0x4b,0xdc,0x56,0xc9,0x43,0x9b,0x68,0xc3,0xc2,0xcf,0x5b,0x25,0xf3,0x24,0x5a,0x06,0x5f,0x5f,0x9a,0xd7,0xe9,0x82,0xf1,0x24,0x01,0xf5,0x5f,0x90,0x2c,0x94,0x22,0xdf,0x27,0x5f,0x20,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
