ruairiD11/ProjectY4/(commit log)

2019-10-25 Created new repository - had some problems commiting with last one
    [DCmotorConfig.ino]
2019-10-25 L293D IC chip added in hardware for motor direction control
2019-10-25 Adding circuit diagrams folder
2019-10-25 Flex sensor controlling brightness of an LED
    [FlexSensorConfig.ino]
2019-10-27 Code from Michalis Vasilakis online changing brightness of LED using flex sensor, I also added some conditional statements to display if finger was open or closed
    [FlexSensorConfig.ino]
2019-10-27 L293D circuit diagram
2019-11-01 Mapping input analog signal from flex sensor to the servo motor
    [servoMotorFlexSensor.ino]
2019-11-23 MPU6050 controlling Servo
2019-11-23 Prototype 2.0 first test
2019-11-23 Accelerometer and flex sensor code added - MPU6050 code was from example Arduino code by Jeff Rowberg - I have referenced it in the code
    [glove.ino]
2019-12-02 Prototype picking up object
2019-12-02 Values read from flex sensors constrained to a min and max to improve output on servo
    [glove.ino]
2019-12-04 Worked out more accurate max and min values for constraining the flex sensors, and also some error checking for the middle sensor
    [glove.ino]
2020-01-26 Glove module with ESP32, using Eclipse IDE
2020-01-29 Setting up ESP32 as an AP
2020-02-18 Writing incoming values to servo motors on the robot module
2020-02-29 Two push buttons (interrupts) controlling stepper motor and performance improvements
2020-04-05 ESP32 CAM code, references attached
2020-04-06 Smoothing average improvement for flex sensor readings
    [main.c]
2020-04-11 Modified to commuincate with new ESP32
